karlp/exp-iio-ads124s08/pi-hat-ads124s08_r1.kicad_pcb

## KiCad design pi-hat-ads124s08_r1.kicad_pcb (2025-10-15)

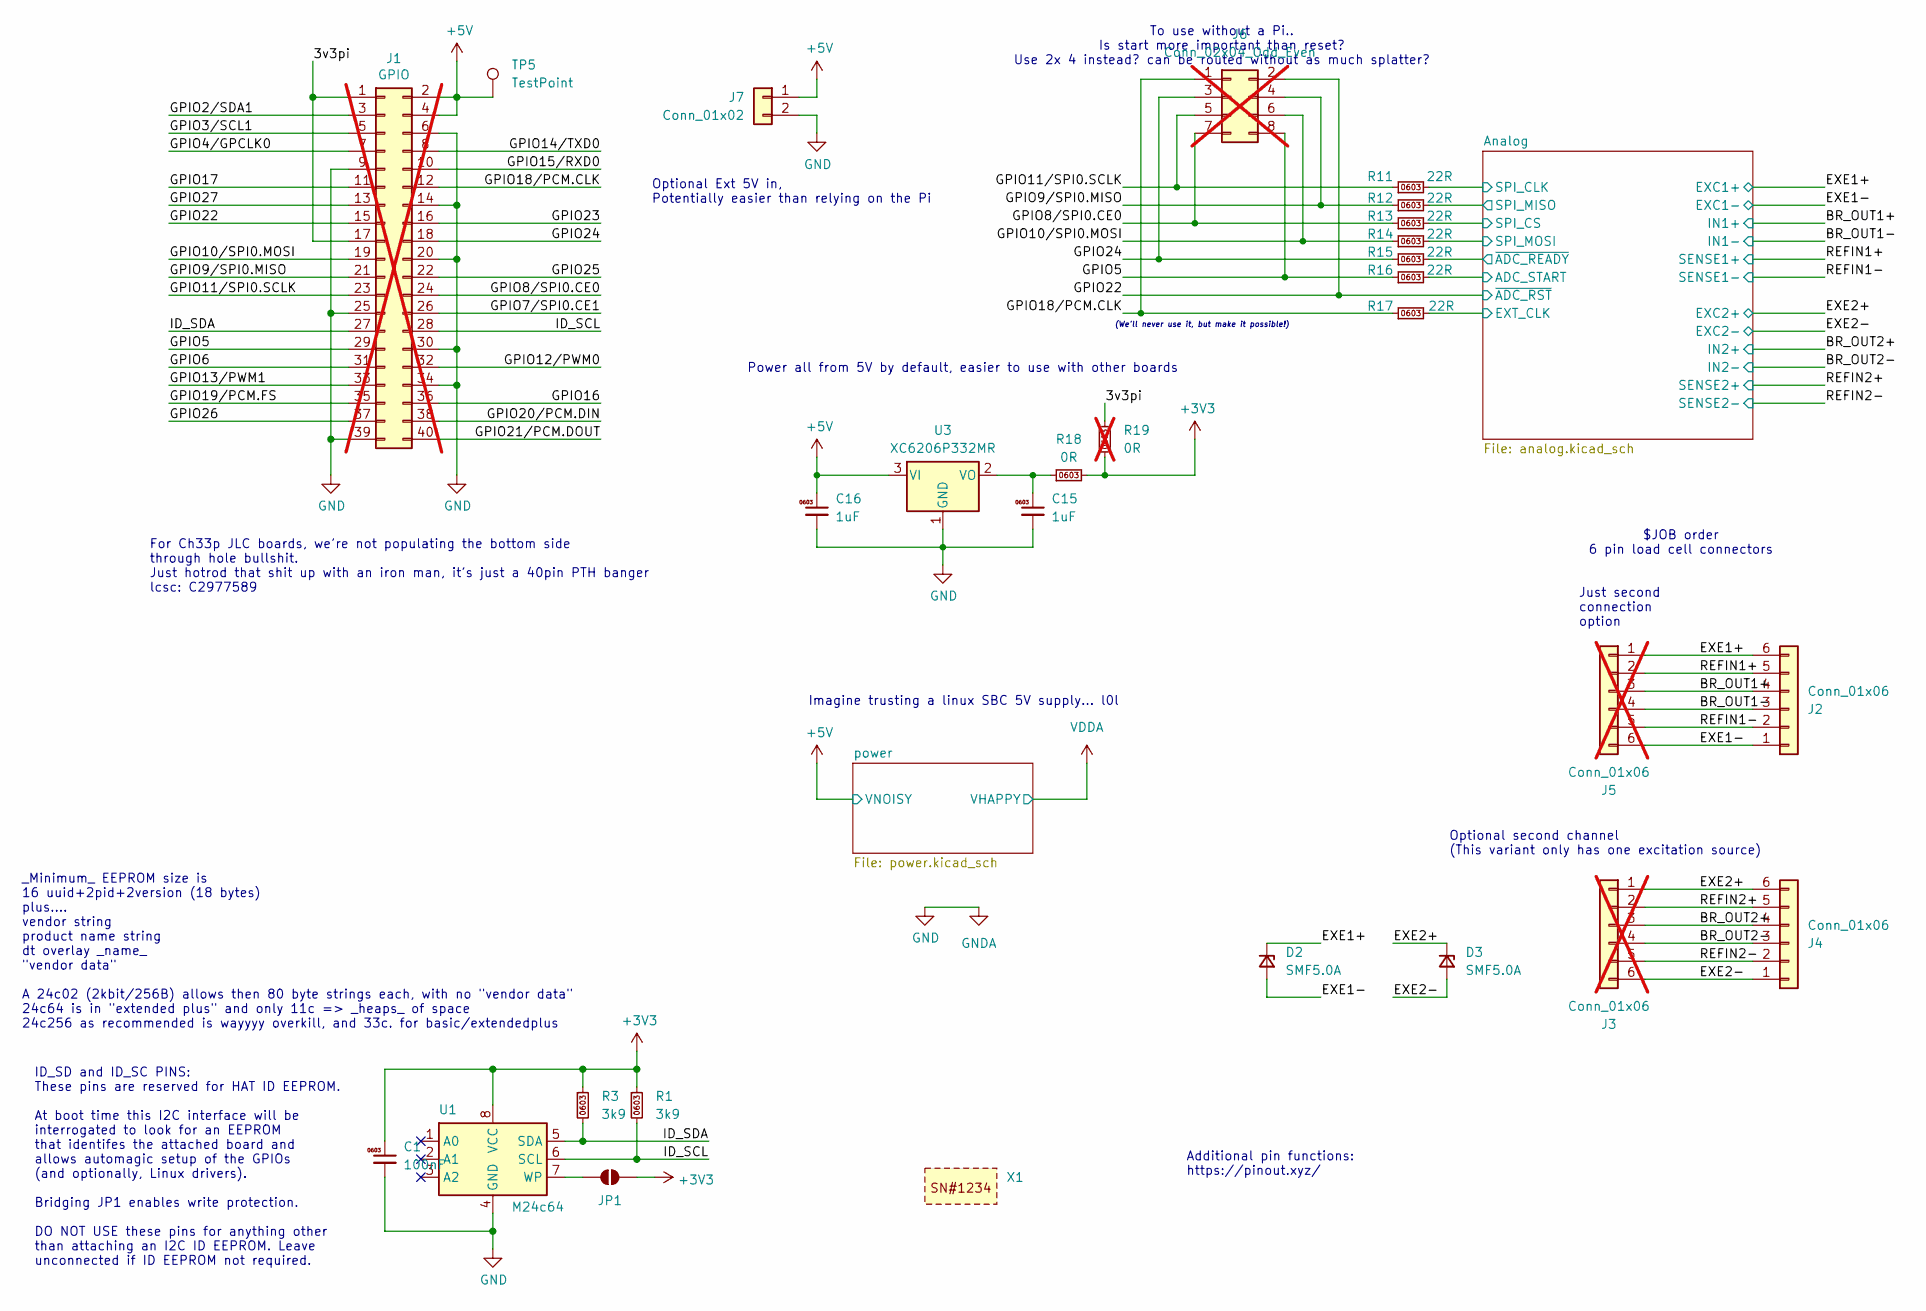
[picture p1: schematic pi-hat-ads124s08_r1.kicad_sch, ADS124S08 Linux IIO Eval PiHAT]

Parts:
C1: 100nF; C_0603_1608Metric; MPN CC0603KRX7R9BB104; LCSC Part # C14663
C15, C16: 1uF; C_0603_1608Metric; MPN CL10A105KB8NNNC; LCSC Part # C15849
D2, D3: SMF5.0A; D_SOD-123F; MPN SMF5.0A; LCSC Part # C19077497
J1: GPIO; PinSocket_2x20_P2.54mm_Vertical; not fitted
J2, J4: Conn_01x06; PhoenixContact_MCV_1,5_6-G-3.81_1x06_P3.81mm_Vertical; MPN KF2EDGV-3.81-6P; LCSC Part # C441336
J3, J5: Conn_01x06; PinHeader_1x06_P2.54mm_Vertical; not fitted
J6: Conn_02x04_Odd_Even; PinHeader_2x04_P2.54mm_Vertical; not fitted
J7: Conn_01x02; PhoenixContact_MCV_1,5_2-G-3.81_1x02_P3.81mm_Vertical; MPN WJ15EDGVC-3.81-2P; LCSC Part # C8396
JP1: ID_WP; SolderJumper-2_P1.3mm_Open_TrianglePad0.9x1.8mm
R1, R3: 3k9; R_0603_1608Metric; MPN 0603WAF3901T5E; LCSC Part # C23018
R11, R12, R13, R14, R15, R16, R17: 22R; R_0603_1608Metric; MPN 0603WAF220JT5E; LCSC Part # C23345
R18: 0R; R_0603_1608Metric; MPN 0603WAF0000T5E; LCSC Part # C21189
R19: 0R; R_0603_1608Metric; MPN 0603WAF0000T5E; LCSC Part # C21189; not fitted
TP5: TestPoint; TestPoint_THTPad_2.0x2.0mm_Drill1.0mm
U1: M24c64; SOIC-8_3.9x4.9mm_P1.27mm; MPN M24C64-RMN6TP; LCSC Part # C79988
U3: XC6206P332MR; SOT-23-3; MPN XC6206P332MR-G; LCSC Part # C5446
X1: JLC_2D_BARCODE_8x8mm

Connections:
+3V3: C1.1, JP1.2 (B), R1.1, R3.1, R18.2, R19.1, U1.8 (VCC); also elsewhere on the board
+5V: C16.1, J1.2, J1.4, J7.1, TP5.1, U3.3 (VI); also elsewhere on the board
/3v3pi: J1.1, J1.17, R19.2
/Analog/ADC_START: R16.2; also elsewhere on the board
/Analog/EXT_CLK: R17.2; also elsewhere on the board
/Analog/SPI_CLK: R11.2; also elsewhere on the board
/Analog/SPI_CS: R13.2; also elsewhere on the board
/Analog/SPI_MISO: R12.2; also elsewhere on the board
/Analog/SPI_MOSI: R14.2; also elsewhere on the board
/Analog/~ADC_READY: R15.2; also elsewhere on the board
/BR_OUT1+: J2.4, J5.3; also elsewhere on the board
/BR_OUT1-: J2.3, J5.4; also elsewhere on the board
/BR_OUT2+: J3.3, J4.4; also elsewhere on the board
/BR_OUT2-: J3.4, J4.3; also elsewhere on the board
/EXE1+: D2.1 (K), D3.1 (K), J2.6, J3.1, J4.6, J5.1; also elsewhere on the board
/GPIO2/SDA1: J1.3
/GPIO3/SCL1: J1.5
/GPIO4/GPCLK0: J1.7
/GPIO5: J1.29, J6.8, R16.1
/GPIO6: J1.31
/GPIO7/SPI0.CE1: J1.26
/GPIO8/SPI0.CE0: J1.24, J6.7, R13.1
/GPIO9/SPI0.MISO: J1.21, J6.4, R12.1
/GPIO10/SPI0.MOSI: J1.19, J6.6, R14.1
/GPIO11/SPI0.SCLK: J1.23, J6.5, R11.1
/GPIO12/PWM0: J1.32
/GPIO13/PWM1: J1.33
/GPIO14/TXD0: J1.8
/GPIO15/RXD0: J1.10
/GPIO16: J1.36
/GPIO17: J1.11
/GPIO18/PCM.CLK: J1.12, J6.1, R17.1
/GPIO19/PCM.FS: J1.35
/GPIO20/PCM.DIN: J1.38
/GPIO21/PCM.DOUT: J1.40
/GPIO22: J1.15, J6.2; also elsewhere on the board
/GPIO23: J1.16
/GPIO24: J1.18, J6.3, R15.1
/GPIO25: J1.22
/GPIO26: J1.37
/GPIO27: J1.13
/ID_SCL: J1.28, R1.2, U1.6 (SCL)
/ID_SDA: J1.27, R3.2, U1.5 (SDA)
/REFIN1+: J2.5, J5.2; also elsewhere on the board
/REFIN1-: J2.2, J5.5; also elsewhere on the board
/REFIN2+: J3.2, J4.5; also elsewhere on the board
/REFIN2-: J3.5, J4.2; also elsewhere on the board
GND: C1.2, C15.2, C16.2, D2.2 (A), D3.2 (A), J1.6, J1.9, J1.14, J1.20, J1.25, J1.30, J1.34, J1.39, J2.1, J3.6, J4.1, J5.6, J7.2, U1.4 (GND), U3.1 (GND); also elsewhere on the board
unnamed: JP1.1 (A), U1.7 (WP)
unnamed: C15.1, R18.1, U3.2 (VO)

Notes on the sheet:
Optional Ext 5V in, Potentially easier than relying on the Pi
Just second connection option
_Minimum_ EEPROM size is 16 uuid+2pid+2version (18 bytes) plus.... vendor string product name string dt overlay _name_ "vendor data" A 24c02 (2kbit/256B) allows then 80 byte strings each, with no "vendor data" 24c64 is in "extended plus" and only 11c => _heaps_ of space 24c256 as recommended is way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
To use without a Pi.. Is start more important than reset? Use 2x 4 instead? can be routed without as much splatter?
Additional pin functions: https://pinout.xyz/
$JOB order 6 pin load cell connectors
Power all from 5V by default, easier to use with other boards
ID_SD and ID_SC PINS: These pins are reserved for HAT ID EEPROM. At boot time this I2C interface will be interrogated to look for an EEPROM that identifes the attached board and allows automagic setup of the GPIOs (and optionally, Linux drivers). Bridging JP1 enables write protection. DO NOT USE th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
Optional second channel (This variant only has one excitation source)
For Ch33p JLC boards, we're not populating the bottom side through hole bullshit. Just hotrod that shit up with an iron man, it's just a 40pin PTH banger lcsc: C2977589
(We'll never use it, but make it possible!)
Imagine trusting a linux SBC 5V supply... l0l

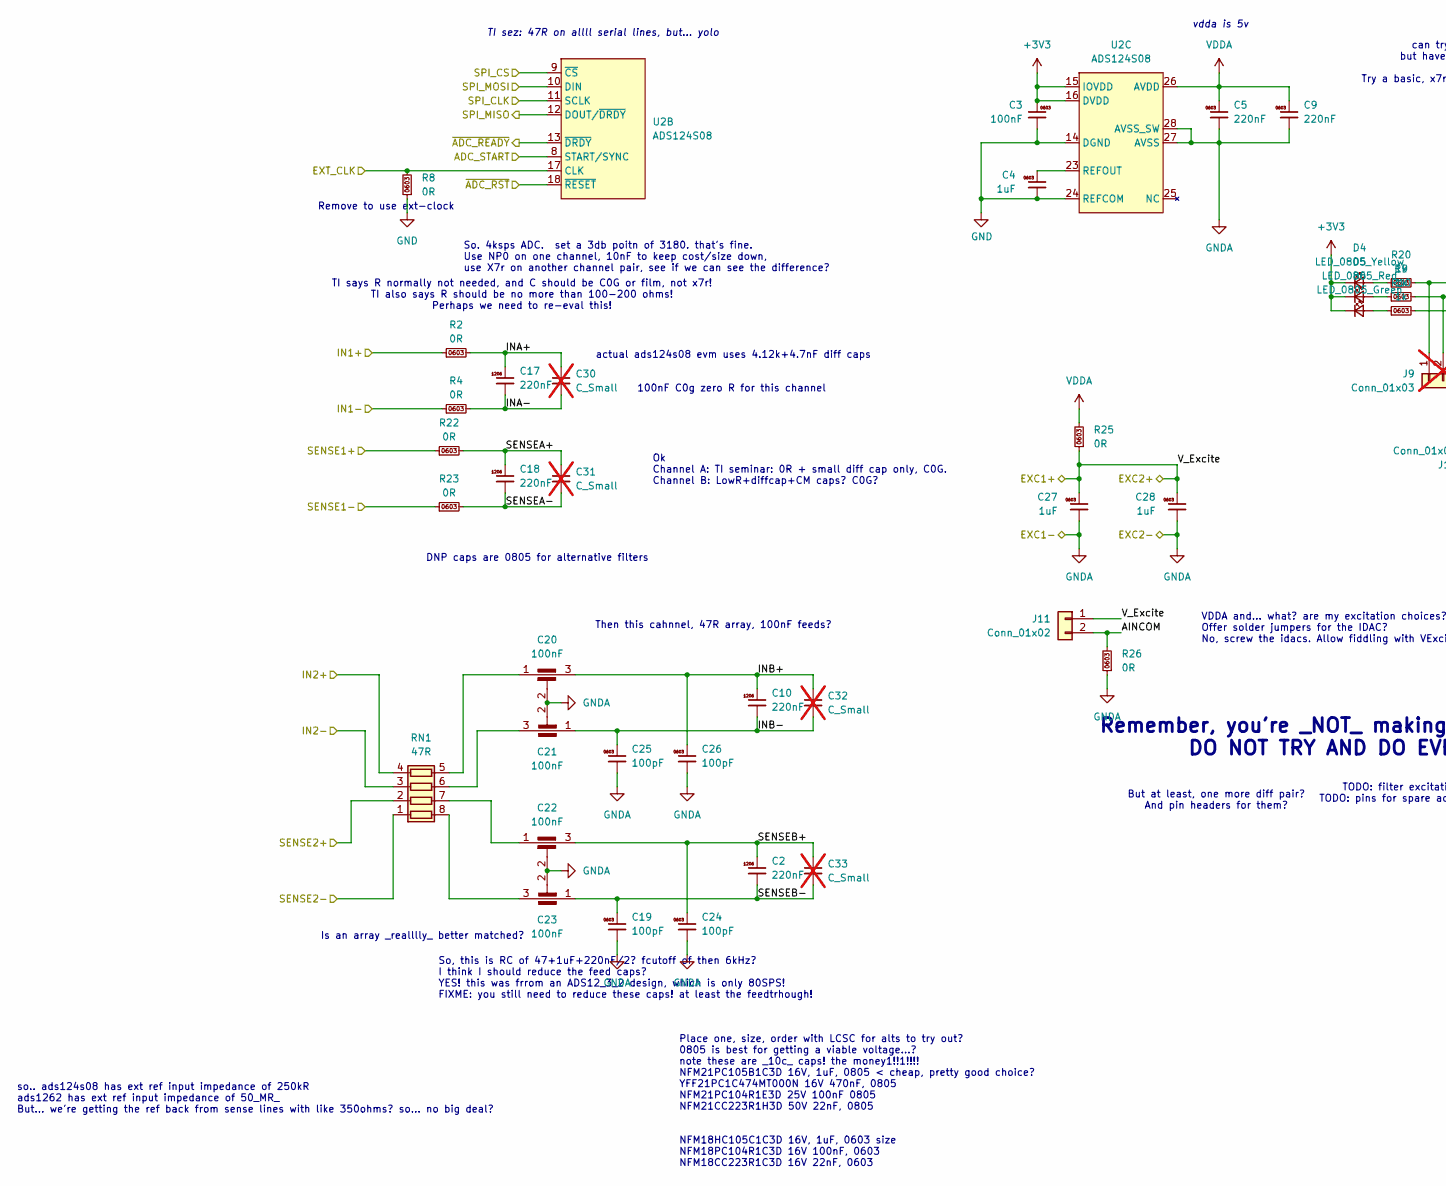
[picture p2: schematic analog.kicad_sch, part in row 1, column 1]

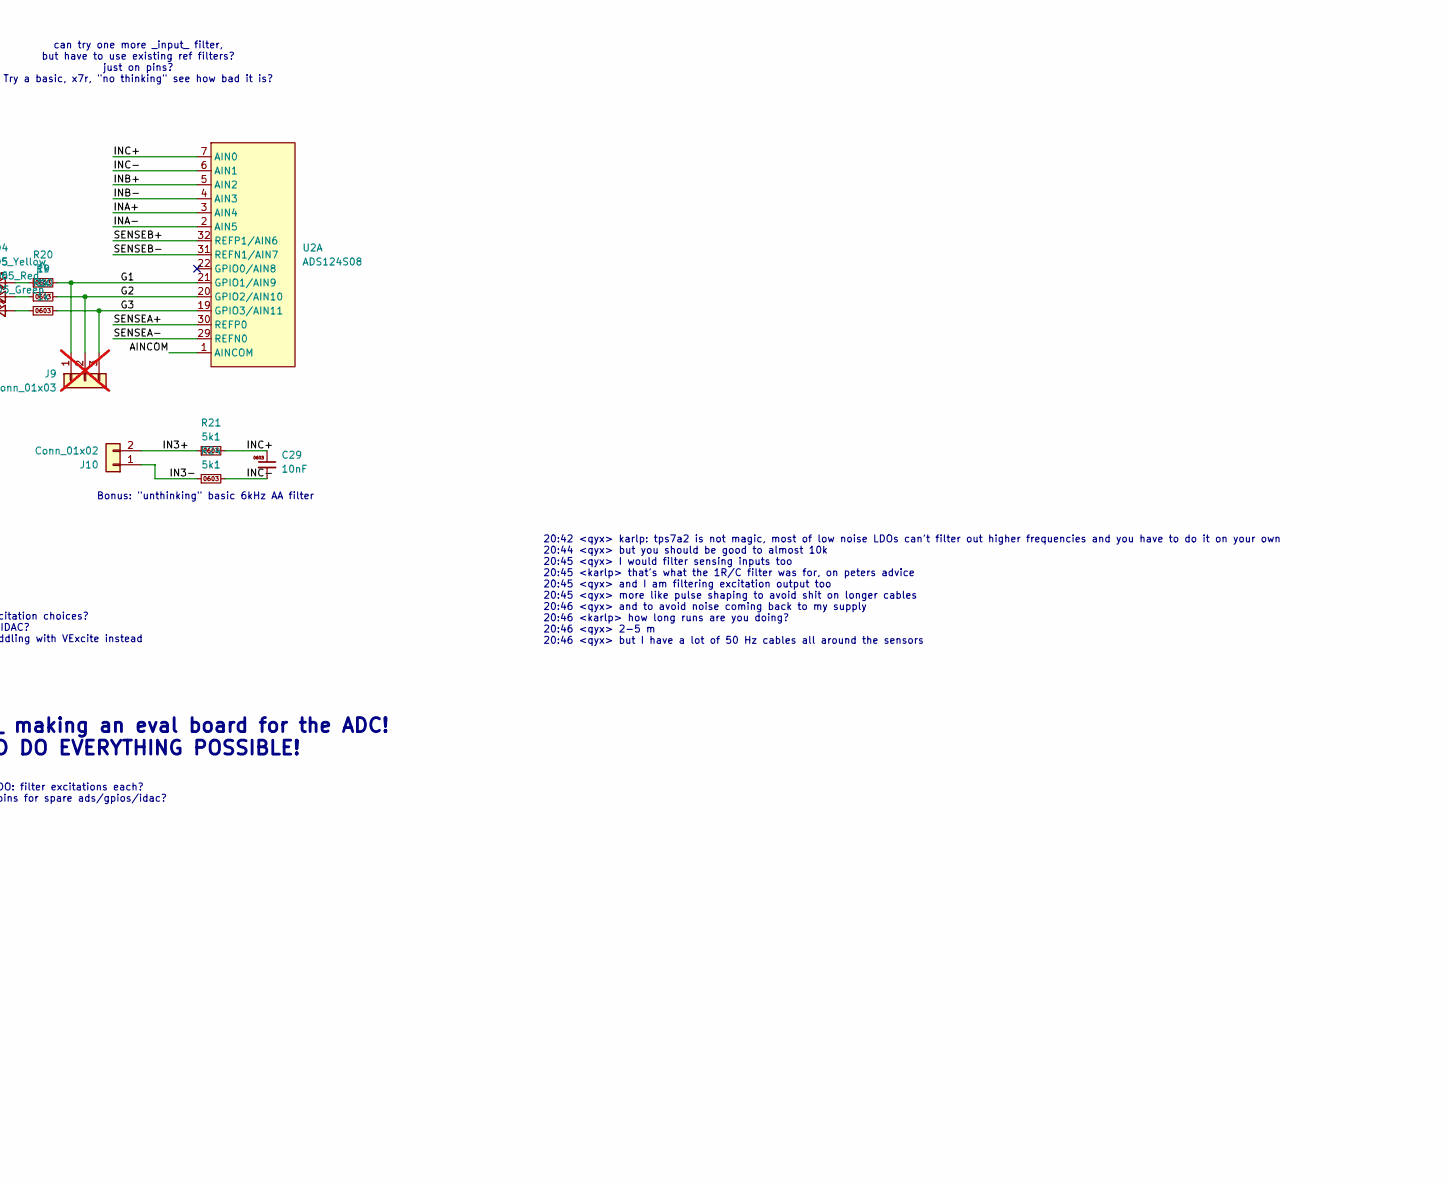
[picture p3: schematic analog.kicad_sch, part in row 1, column 2]

Parts:
C2, C10, C17, C18: 220nF; C_1206_3216Metric; MPN GRM31C5C1H224JE02L; LCSC Part # C464977
C3: 100nF; C_0603_1608Metric; MPN CC0603KRX7R9BB104; LCSC Part # C14663
C4, C27, C28: 1uF; C_0603_1608Metric; MPN CL10A105KB8NNNC; LCSC Part # C15849
C5, C9: 220nF; C_0603_1608Metric; MPN CL10B224KA8NNNC; LCSC Part # C21120
C19, C24, C25, C26: 100pF; C_0603_1608Metric; MPN CL10C101JB8NNNC; LCSC Part # C14858
C20, C21, C22, C23: 100nF; C_Feedthrough_NFM21_2.0mmx1.2mm; MPN NFM21PC104R1E3D; LCSC Part # C86150
C29: 10nF; C_0603_1608Metric; MPN 0603B103K500NT; LCSC Part # C57112
C30, C31, C32, C33: C_Small; C_0805_2012Metric; not fitted
D4: LED_0805_Yellow; LED_0805_2012Metric; MPN KT-0805Y; LCSC Part # C2296
D5: LED_0805_Red; LED_0805_2012Metric; MPN NCD0805R1; LCSC Part # C84256
D6: LED_0805_Green; LED_0805_2012Metric; MPN KT-0805G; LCSC Part # C2297
J9: Conn_01x03; PinHeader_1x03_P2.54mm_Vertical; not fitted
J10, J11: Conn_01x02; PhoenixContact_MCV_1,5_2-G-3.81_1x02_P3.81mm_Vertical; MPN WJ15EDGVC-3.81-2P; LCSC Part # C8396
R2, R4, R8, R22, R23, R25, R26: 0R; R_0603_1608Metric; MPN 0603WAF0000T5E; LCSC Part # C21189
R9, R10, R20: 1k; R_0603_1608Metric; MPN 0603WAF1001T5E; LCSC Part # C21190
R21, R24: 5k1; R_0603_1608Metric; MPN 0603WAF5101T5E; LCSC Part # C23186
RN1: 47R; R_Array_Convex_4x0603; MPN 4D03WGF470JT5E; LCSC Part # C425204
U2: ADS124S08; LQFP-32_5x5mm_P0.5mm; MPN ADS124S08IPBSR; LCSC Part # C2870171

Connections:
+3V3: C3.1, D4.1 (K), D5.1 (K), D6.1 (K), U2.15 (IOVDD), U2.16 (DVDD); also elsewhere on the board
/Analog/ADC_START: U2.8 (START/SYNC); also elsewhere on the board
/Analog/AINCOM: J11.2, R26.2, U2.1 (AINCOM)
/Analog/EXT_CLK: R8.2, U2.17 (CLK); also elsewhere on the board
/Analog/G1: J9.1, R20.2, U2.21 (GPIO1/AIN9)
/Analog/G2: J9.2, R9.2, U2.20 (GPIO2/AIN10)
/Analog/G3: J9.3, R10.2, U2.19 (GPIO3/AIN11)
/Analog/IN3+: J10.2, R21.1
/Analog/IN3-: J10.1, R24.1
/Analog/INA+: C17.1, C30.1, R2.2, U2.3 (AIN4)
/Analog/INA-: C17.2, C30.2, R4.2, U2.2 (AIN5)
/Analog/INB+: C10.1, C20.3, C26.1, C32.1, U2.5 (AIN2)
/Analog/INB-: C10.2, C21.1, C25.1, C32.2, U2.4 (AIN3)
/Analog/INC+: C29.1, R21.2, U2.7 (AIN0)
/Analog/INC-: C29.2, R24.2, U2.6 (AIN1)
/Analog/SENSEA+: C18.1, C31.1, R22.2, U2.30 (REFP0)
/Analog/SENSEA-: C18.2, C31.2, R23.2, U2.29 (REFN0)
/Analog/SENSEB+: C2.1, C22.3, C24.1, C33.1, U2.32 (REFP1/AIN6)
/Analog/SENSEB-: C2.2, C19.1, C23.1, C33.2, U2.31 (REFN1/AIN7)
/Analog/SPI_CLK: U2.11 (SCLK); also elsewhere on the board
/Analog/SPI_CS: U2.9 (~CS); also elsewhere on the board
/Analog/SPI_MISO: U2.12 (DOUT/~DRDY); also elsewhere on the board
/Analog/SPI_MOSI: U2.10 (DIN); also elsewhere on the board
/Analog/~ADC_READY: U2.13 (~DRDY); also elsewhere on the board
/BR_OUT1+: R2.1; also elsewhere on the board
/BR_OUT1-: R4.1; also elsewhere on the board
/BR_OUT2+: RN1.4 (R4.1); also elsewhere on the board
/BR_OUT2-: RN1.3 (R3.1); also elsewhere on the board
/EXE1+: C27.1, C28.1, J11.1, R25.1; also elsewhere on the board
/GPIO22: U2.18 (~RESET); also elsewhere on the board
/REFIN1+: R22.1; also elsewhere on the board
/REFIN1-: R23.1; also elsewhere on the board
/REFIN2+: RN1.2 (R2.1); also elsewhere on the board
/REFIN2-: RN1.1 (R1.1); also elsewhere on the board
GND: C3.2, C4.2, C5.2, C9.2, C19.2, C20.2, C21.2, C22.2, C23.2, C24.2, C25.2, C26.2, C27.2, C28.2, R8.1, R26.1, U2.14 (DGND), U2.24 (REFCOM), U2.27 (AVSS), U2.28 (AVSS_SW); also elsewhere on the board
unnamed: D4.2 (A), R20.1
unnamed: D5.2 (A), R9.1
unnamed: D6.2 (A), R10.1
unnamed: C23.3, RN1.8 (R1.2)
unnamed: C22.1, RN1.7 (R2.2)
unnamed: C21.3, RN1.6 (R3.2)
unnamed: C20.1, RN1.5 (R4.2)
unnamed: C4.1, U2.23 (REFOUT)
VDDA: C5.1, C9.1, R25.2, U2.26 (AVDD); also elsewhere on the board

Notes on the sheet:
DNP caps are 0805 for alternative filters
So, this is RC of 47+1uF+220nF/2? fcutoff of then 6kHz? I think I should reduce the feed caps? YES! this was frrom an ADS12_3_2 design, which is only 80SPS! FIXME: you still need to reduce these caps! at least the feedtrhough!
so.. ads124s08 has ext ref input impedance of 250kR ads1262 has ext ref input impedance of 50_MR_ But... we're getting the ref back from sense lines with like 350ohms? so... no big deal?
Remove to use ext-clock
So. 4ksps ADC. set a 3db poitn of 3180. that's fine. Use NP0 on one channel, 10nF to keep cost/size down, use X7r on another channel pair, see if we can see the difference?
TODO: filter excitations each? TODO: pins for spare ads/gpios/idac?
Place one, size, order with LCSC for alts to try out? 0805 is best for getting a viable voltage...? note these are _10c_ caps! the money1!!1!!!! NFM21PC105B1C3D 16V, 1uF, 0805 < cheap, pretty good choice? YFF21PC1C474MT000N 16V 470nF, 0805 NFM21PC104R1E3D 25V 100nF 0805 NFM21CC223R1H3D 50V 22nF, 08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
Is an array _realllly_ better matched?
VDDA and... what? are my excitation choices? Offer solder jumpers for the IDAC? No, screw the idacs. Allow fiddling with VExcite instead
100nF C0g zero R for this channel
TI sez: 47R on allll serial lines, but... yolo
can try one more _input_ filter, but have to use existing ref filters? just on pins? Try a basic, x7r, "no thinking" see how bad it is?
Bonus: "unthinking" basic 6kHz AA filter
Remember, you're _NOT_ making an eval board for the ADC! DO NOT TRY AND DO EVERYTHING POSSIBLE!
actual ads124s08 evm uses 4.12k+4.7nF diff caps
TI says R normally not needed, and C should be C0G or film, not x7r! TI also says R should be no more than 100-200 ohms! Perhaps we need to re-eval this!
20:42 <qyx> karlp: tps7a2 is not magic, most of low noise LDOs can't filter out higher frequencies and you have to do it on your own 20:44 <qyx> but you should be good to almost 10k 20:45 <qyx> I would filter sensing inputs too 20:45 <karlp> that's what the 1R/C filter was for, on peters advice 20: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
Ok Channel A: TI seminar: 0R + small diff cap only, C0G. Channel B: LowR+diffcap+CM caps? C0G?
But at least, one more diff pair? And pin headers for them?
Then this cahnnel, 47R array, 100nF feeds?
vdda is 5v

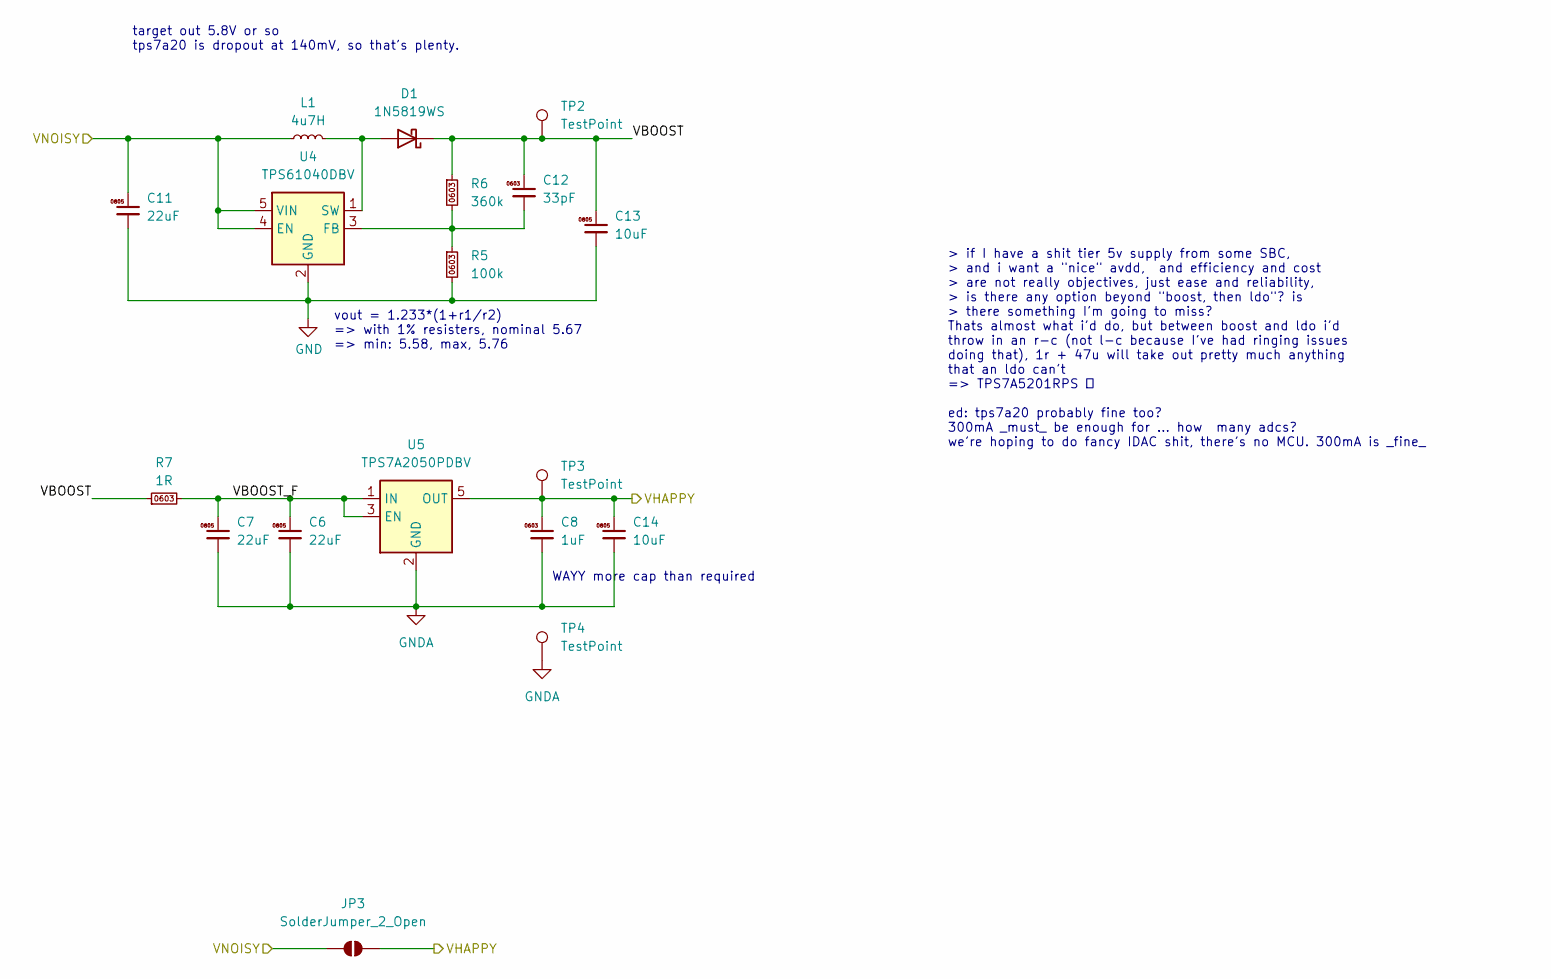
[picture p4: schematic power.kicad_sch]

Parts:
C6, C7, C11: 22uF; C_0805_2012Metric; MPN CL21A226MAQNNNE; LCSC Part # C45783
C8: 1uF; C_0603_1608Metric; MPN CL10A105KB8NNNC; LCSC Part # C15849
C12: 33pF; C_0603_1608Metric; MPN CL10C330JB8NNNC; LCSC Part # C1663
C13, C14: 10uF; C_0805_2012Metric; MPN CL21A106KAYNNNE; LCSC Part # C15850
D1: 1N5819WS; D_SOD-323; MPN 1N5819WS; LCSC Part # C191023
JP3: SolderJumper_2_Open; SolderJumper-2_P1.3mm_Open_TrianglePad0.9x1.8mm
L1: 4u7H; L_Changjiang_FNR4030S; MPN FNR4030S4R7MT; LCSC Part # C167874
R5: 100k; R_0603_1608Metric; MPN 0603WAF1003T5E; LCSC Part # C25803
R6: 360k; R_0603_1608Metric; MPN 0603WAF3603T5E; LCSC Part # C23146
R7: 1R; R_0603_1608Metric; MPN 0603WAF100KT5E; LCSC Part # C22936
TP2, TP3, TP4: TestPoint; TestPoint_THTPad_2.0x2.0mm_Drill1.0mm
U4: TPS61040DBV; SOT-23-5; MPN TPS61040DBVR; LCSC Part # C7722
U5: TPS7A2050PDBV; SOT-23-5; MPN TPS7A2050PDBVR; LCSC Part # C2864504

Connections:
+5V: C11.1, JP3.1 (A), L1.1, U4.4 (EN), U4.5 (VIN); also elsewhere on the board
/power/VBOOST: C12.1, C13.1, D1.1 (K), R6.1, R7.1, TP2.1
/power/VBOOST_F: C6.1, C7.1, R7.2, U5.1 (IN), U5.3 (EN)
GND: C6.2, C7.2, C8.2, C11.2, C13.2, C14.2, R5.2, TP4.1, U4.2 (GND), U5.2 (GND); also elsewhere on the board
unnamed: D1.2 (A), L1.2, U4.1 (SW)
unnamed: C12.2, R5.1, R6.2, U4.3 (FB)
VDDA: C8.1, C14.1, JP3.2 (B), TP3.1, U5.5 (OUT); also elsewhere on the board

Notes on the sheet:
> if I have a shit tier 5v supply from some SBC, > and i want a "nice" avdd, and efficiency and cost > are not really objectives, just ease and reliability, > is there any option beyond "boost, then ldo"? is > there something I'm going to miss? Thats almost what i'd do, but between boost and ldo i'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
vout = 1.233*(1+r1/r2) => with 1% resisters, nominal 5.67 => min: 5.58, max, 5.76
target out 5.8V or so tps7a20 is dropout at 140mV, so that's plenty.
WAYY more cap than required

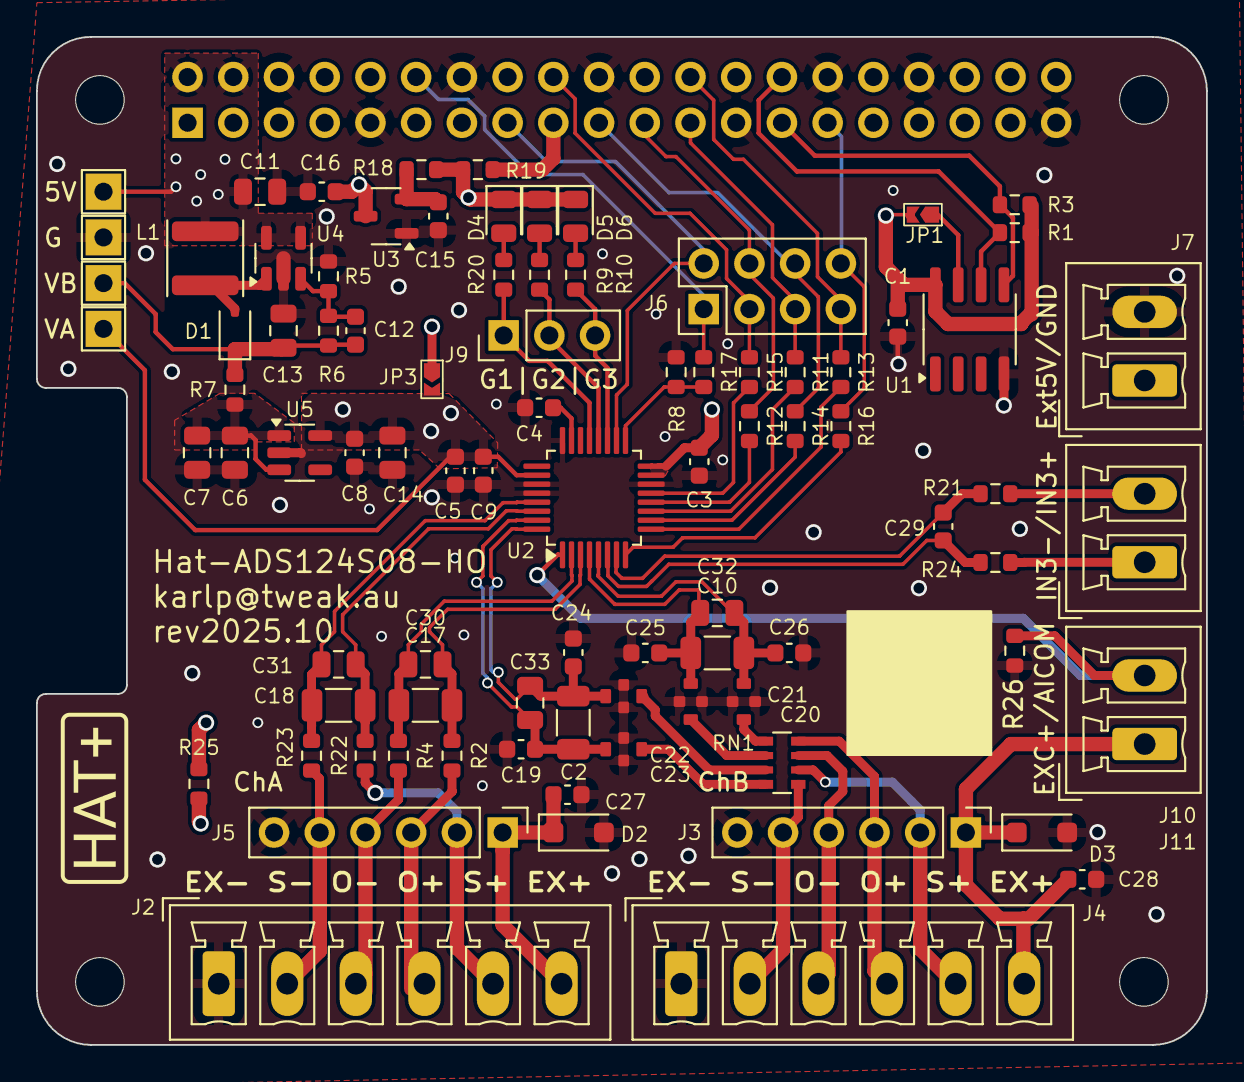
[picture p5: board pi-hat-ads124s08_r1.kicad_pcb from above]

Board: 4 copper layers, 65.0 x 56.0 mm, 93 parts (1 on the bottom side), 61 nets.

Other parts of the board:
MH1, MH2, MH3, MH4: MountingHole_2.7mm_M2.5
