karlp/exp-iio-ads124s08/(commit log)

2025-08-30 initial save
    [pi-hat-hx711_r1.kicad_pcb, pi-hat-hx711_r1.kicad_sch]
2025-08-30 continuing.
    might as well have channel b be usable for sense.
    provide options for bypassing power shits though.
    still ratiometric, just avoiding whatever is in the hx711 itself.
    [pi-hat-hx711_r1.kicad_sch]
2025-08-30 add the sheets that we refactored too...
    [analog.kicad_sch, pi-hat-hx711_r1.kicad_sch, power.kicad_sch]
2025-08-30 just pretty-fying
    [power.kicad_sch]
2025-08-30 rough blocking out the pcb
    [analog.kicad_sch, pi-hat-hx711_r1.kicad_pcb, pi-hat-hx711_r1.kicad_sch, power.kicad_sch]
2025-09-01 better parts, start pushing layout blocks
    SMA is dumb, way too big
    the swpa3030 was... unnecessarily small. we're trying to be super chill
    power here, don't push it hot. (Still, 1A was.. really, more than
    enough? but 1A is a 40C rise, so.. let's just have less....)
    use more caps too. why the fuck not. more filtering, more happy.
    holy fuck though, kicad on wayland is giving me the shits!
    [analog.kicad_sch, pi-hat-hx711_r1.kicad_pcb, power.kicad_sch]
2025-09-01 add second channel input
    switch to vertical connectors, so no concerns abotu edge space.
    Allows offering the second channel, even though it's probably useless,
    but it sets us up with a style we might be ok with for subsequent
    boards.
    [analog.kicad_sch, pi-hat-hx711_r1.kicad_pcb, pi-hat-hx711_r1.kicad_sch, power.kicad_sch]
2025-09-01 pushing blocks
    roughyl how we want it?
    [pi-hat-hx711_r1.kicad_pcb, power.kicad_sch]
2025-09-02 chunk out routing
    looks okish?
    switched x2son for plain sot235, it's better stocked at jlc anyway, and
    easier to probe and work with.
    [analog.kicad_sch, pi-hat-hx711_r1.kicad_pcb, power.kicad_sch]
2025-09-02 pushing silk, are we done?!
    [pi-hat-hx711_r1.kicad_pcb, power.kicad_sch]
2025-09-04 wheeww!
    Added 3.3v supply from 5V by default.
    Added header to access IOs without rpi
    Added TP to supply/monitor raw 5V (use without pi)
    Adjusted TPs to be on 2.54mm spacing to get headers if desired
    Added TVS on EXE+ lines.
    [analog.kicad_sch, pi-hat-hx711_r1.kicad_pcb, pi-hat-hx711_r1.kicad_sch, power.kicad_sch]
2025-09-04 erc/drc cleanups
    fix lots of off grid stuff that got dragged off in earlier
    re-arrangements
    [analog.kicad_sch, pi-hat-hx711_r1.kicad_pcb, pi-hat-hx711_r1.kicad_sch, power.kicad_sch]
2025-09-04 adds a 2 pin power in connector
    I don't have any suitable power supplies for RPi, so just put on a
    connector to use external if desired. Totally raw unprotected, just
    feeds straight to the rpi.
    [pi-hat-hx711_r1.kicad_pcb, pi-hat-hx711_r1.kicad_sch]
2025-10-06 initial cut.
    power and serial interface first cut complete...
    [analog.kicad_sch, pi-hat-ads124s08_r1.kicad_pcb, pi-hat-ads124s08_r1.kicad_sch, power.kicad_sch]
2025-10-07 blocking out...
    [analog.kicad_sch, pi-hat-ads124s08_r1.kicad_pcb, pi-hat-ads124s08_r1.kicad_sch]
2025-10-08 progressing, blocking things out, pondering orbz
    [analog.kicad_sch, pi-hat-ads124s08_r1.kicad_pcb, pi-hat-ads124s08_r1.kicad_sch]
2025-10-08 notes and tweaks.
    notes on inputs, filter ref, spi series R.
    [analog.kicad_sch, pi-hat-ads124s08_r1.kicad_sch]
2025-10-09 overhausl inputs a lot
    read too much, thought too much.
    try one with the "just 0R plus a nice big good quality cap" from the TI
    precision seminar, describing common realities, as well as mixing in
    what they did on the ads1262ref scale design document for the second
    channel with a more "full blown" input filter.
    I don't really like how none of this seems to be a proper AA filter,
    but... ok.
    [analog.kicad_sch, pi-hat-ads124s08_r1.kicad_pcb, pi-hat-ads124s08_r1.kicad_sch, power.kicad_sch]
2025-10-09 thanks, I hate it.
    [analog.kicad_sch, pi-hat-ads124s08_r1.kicad_pcb, pi-hat-ads124s08_r1.kicad_sch]
2025-10-13 moarh updates
    we commit to save our progress
    [analog.kicad_sch, pi-hat-ads124s08_r1.kicad_pcb, pi-hat-ads124s08_r1.kicad_sch, power.kicad_sch]
2025-10-14 "ready" ?
    Added 0805 footprints for the diff caps, to try different values there.
    for the smaller nF values, 080 is _way_ cheaper than the 1206 that's
    ~required for the big nF values.
    Pushed a lot of silk....
    [analog.kicad_sch, pi-hat-ads124s08_r1.kicad_pcb]
2025-10-15 "final" to order
    added a jumper for aincom to ground.
    [analog.kicad_sch, pi-hat-ads124s08_r1.kicad_pcb]
2025-10-15 Saving what was ordered.
    $12 PCBs, $70 parts and assembly for 5. not bad.
    [BOM-pi-hat-ads124s08_r1.csv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]
